crsknr/coffee-tracker/nextion/media/background/background-boot.png

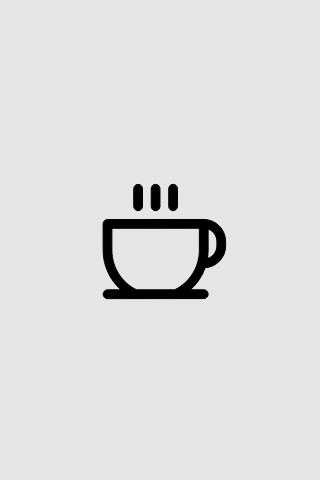
nextion/media/background/background-boot.png
