crsknr/coffee-tracker/nextion/media/background/background-card.png

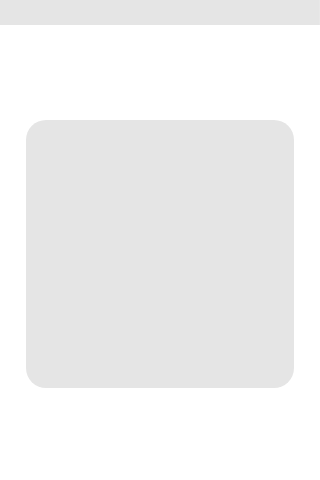
nextion/media/background/background-card.png
