crsknr/coffee-tracker/nextion/media/background/background-default.png

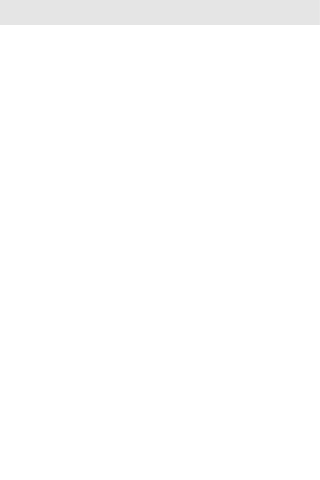
nextion/media/background/background-default.png
