crsknr/coffee-tracker/case/case-bottom.step

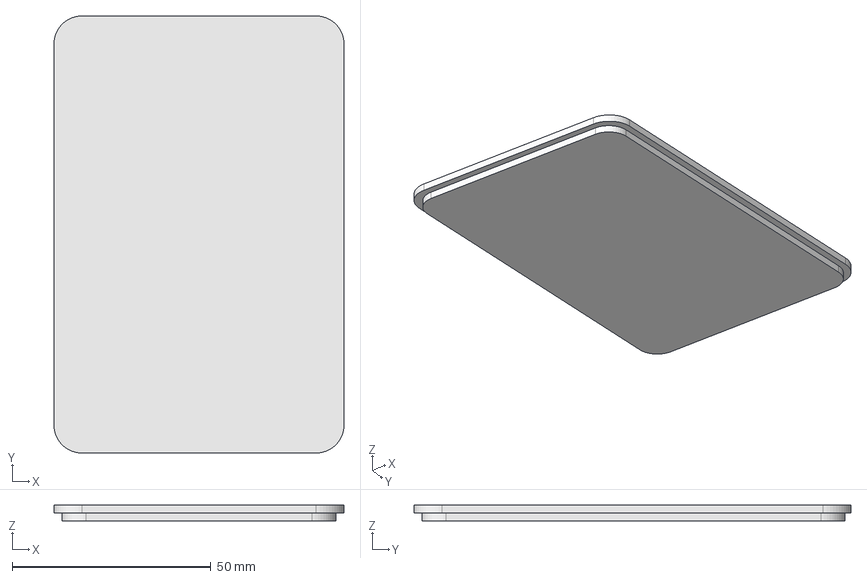
[picture p13: CAD file, 2026-03-11]
case/case-bottom.step
73.0 x 110.0 x 4.00 mm
