crsknr/coffee-tracker/case/case-top.step

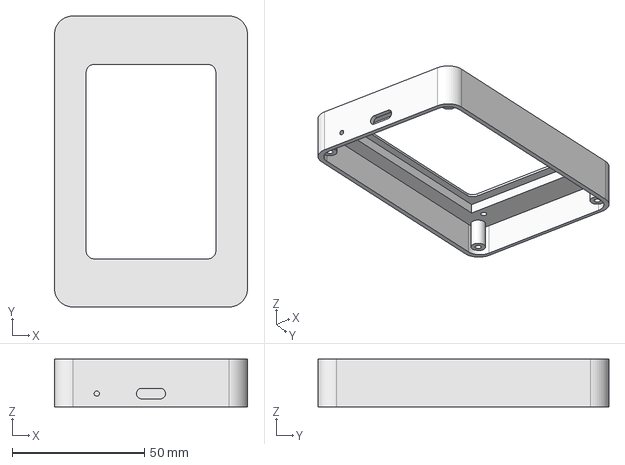
[picture p14: CAD file, 2026-03-11]
case/case-top.step
73.0 x 110.0 x 18.0 mm
