crsknr/coffee-tracker/case/case.FCStd

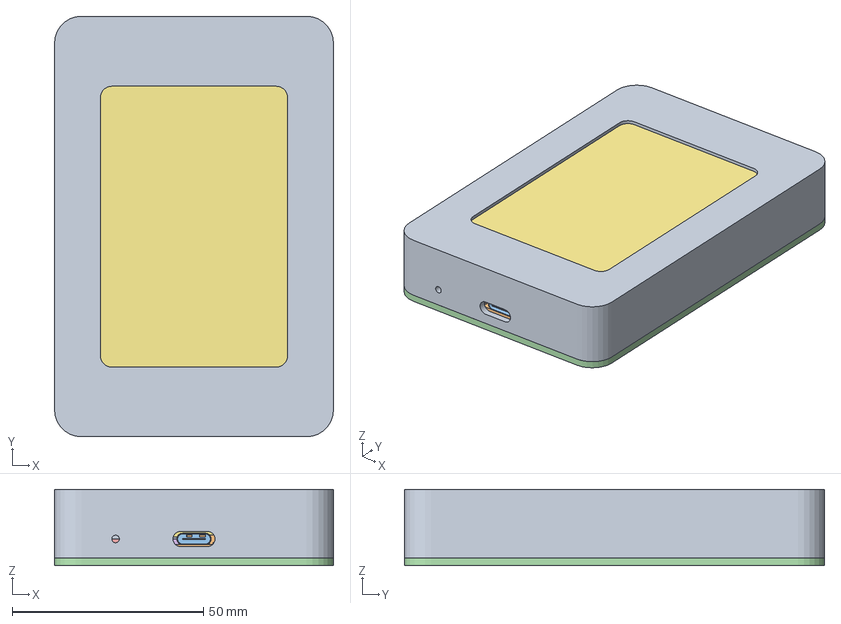
[picture p15: CAD file, 2026-03-11]
case/case.FCStd
73.0 x 110.0 x 20.0 mm
top
ESP32-S3
ESP32-S004
ESP32-S005
ESP32-S006
ESP32-S007
ESP32-S008
ESP32-S009
ESP32-S010
ESP32-S011
ESP32-S012
ESP32-S013
ESP32-S014
ESP32-S015
ESP32-S016
ESP32-S017
ESP32-S018
ESP32-S019
ESP32-S020
ESP32-S021
ESP32-S022
ESP32-S023
ESP32-S024
ESP32-S025
ESP32-S026
ESP32-S027
ESP32-S028
ESP32-S029
ESP32-S030
ESP32-S031
ESP32-S032
ESP32-S033
ESP32-S034
ESP32-S035
ESP32-S036
bottom
Mic
SD
3.5-Display
