crsknr/coffee-tracker/(commit log)

2026-02-26 bug fixes and new audio algorithm
    [config.example.h, main.cpp]
2026-03-11 finalize case
    [case-bottom.step, case-top.step, case.FCStd]
2026-10-08 logic fix + updated ui
    [config.example.h, main.cpp]
2026-10-18 repo cleanup
    [3.5-Bezel.STL, 3.5-Display.STL, ESP32-S3.stp, ESP32-S3_pin.stp]
